LJO-S/antsdr-fmcw-radar/scripts/antenna_design/eps_r_sweep.md

# eps_r sweep, fixed geometry (K8 calibration curve)

Generated by `sweep_eps_r.py`, do not edit by hand. Per-run plots and logs in `sweep/`.

One geometry in every row: the eps_r 4.40 design from `results.md` (patch L
11.842 mm, W 15.728 mm, inset 3.700 mm, line 2.868 mm), on one shared mesh
(`--refine 1.5`, converged to ~3 MHz). Only the substrate's eps_r changes. FR4
dielectric h 1.500 mm, tan d 0.020. S11 is at the board edge, vs 50 Ohm. Efficiency
is radiated over accepted power at the port's probes (PEC copper, so no conductor loss);
gain = Dmax x efficiency.

| eps_r | S11 min at (GHz) | S11 min (dB) | -10 dB band (GHz) | worst over 5.75-5.85 GHz (dB) | Dmax (dBi) | Efficiency (%) | Gain (dBi) |
|---|---|---|---|---|---|---|---|
| 4.20 | 5.924 | -30.2 | 5.813-6.038 | -6.7 | 8.0 | 61 | 5.9 |
| 4.30 | 5.862 | -32.0 | 5.752-5.975 | -9.9 | 8.0 | 60 | 5.8 |
| 4.40 | 5.801 | -33.4 | 5.692-5.914 | -16.3 | 8.0 | 59 | 5.7 |
| 4.50 | 5.743 | -36.7 | 5.636-5.853 | -10.3 | 7.9 | 58 | 5.6 |
| 4.60 | 5.686 | -41.3 | 5.581-5.795 | -7.0 | 7.9 | 58 | 5.5 |

Slope (linear fit): -60 MHz per +0.1 eps_r.

Reading a measurement: `python sweep_eps_r.py --measured <GHz>` interpolates this table
(no new simulation), and prints the guide's formula
`eps_r ~ 4.4 * (f_sim / f_meas)^2` (f_sim = 5.801 GHz) as a cross-check.

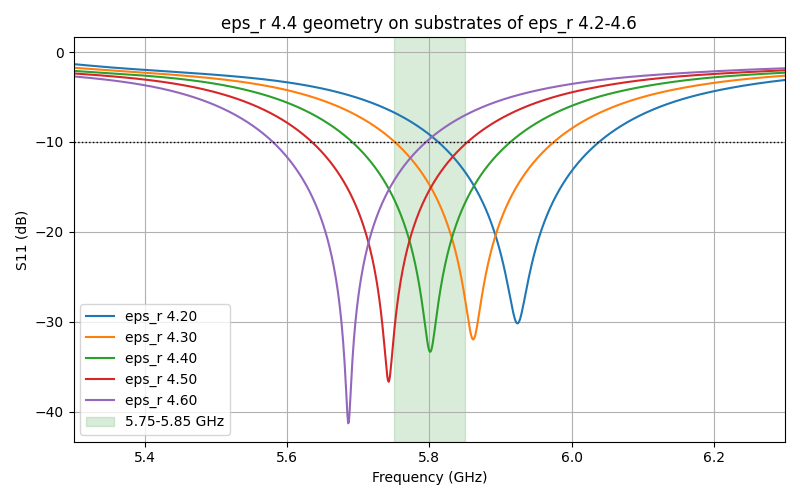
[picture p1: scripts/antenna_design/eps_r_sweep.png]
S11 vs eps_r
