LJO-S/antsdr-fmcw-radar/scripts/antenna_design/k8/k8_summary.md

# K8 summary

K8 denotes the abbreviation of Part K Step 8 in Phase 6 of radar project.
Generated by `k8_analyze.py` after measuring the patch and line-pair from JLCPCB (21 Oct 2026).

```
K8 measurement analysis

Patch board
  S11 minimum:        5.8193 GHz, -11.5 dB
  -10 dB band:        5.608-5.910 GHz
  worst S11 5.75-5.85 GHz: -11.0 dB
  eps_r (table):      4.370
  eps_r (SMA-corr.):  4.412   (f_min - 25 MHz, +-10 MHz ~ +-0.02; the better patch value)
  eps_r (formula):    4.373   (4.4 * (f_sim / f_meas)^2, cross-check)

Line pair (dL 70.0 mm, W 2.868 mm, h 1.50 mm)
  eps_eff at 5.8 GHz: 3.826   (eigenvalue method, launches cancelled; 2 pi wraps added: 2)
  eps_eff 5.75-5.85:  3.823 +- 0.024 (ripple)
  group index:        2.031
  lambda_g at 5.8 GHz: 26.43 mm   (K9 element pitch)
  loss:               0.0195 +- 0.0056 dB/mm (mean over band, ripple)
  cross-check, plain S21 difference: eps_eff 3.822, 0.0115 dB/mm (launches do not cancel in |S21|)
  worst S11 5.75-5.85 GHz: short -5.9 dB, long -8.2 dB
  Z0 (H-J, eps_r 4.4): 50.1 Ohm
  eps_r, Kirschning-Jansen inverted: 4.867   (cross-check)
  eps_r, simulated table (refine 1.5): raw 4.848, corrected 4.847 (35 um copper: eps_eff - 0.0011)
  WARNING: measured eps_eff is outside the simulated table: eps_r is an extrapolation
  (FR4 is anisotropic: the line and patch eps_r may differ by a few %)
  eps_eff predicted from the patch eps_r: 3.452 (measured 3.826)
  conductor loss assumed: 1.07-1.45 dB/m (0.63 smooth x 1.7-2.3 roughness/HASL, an estimate)
  tan d: 0.0184 - 0.0188   (high end = low conductor loss)
```
