LJO-S/antsdr-fmcw-radar/docs/datasheets/hf240.png

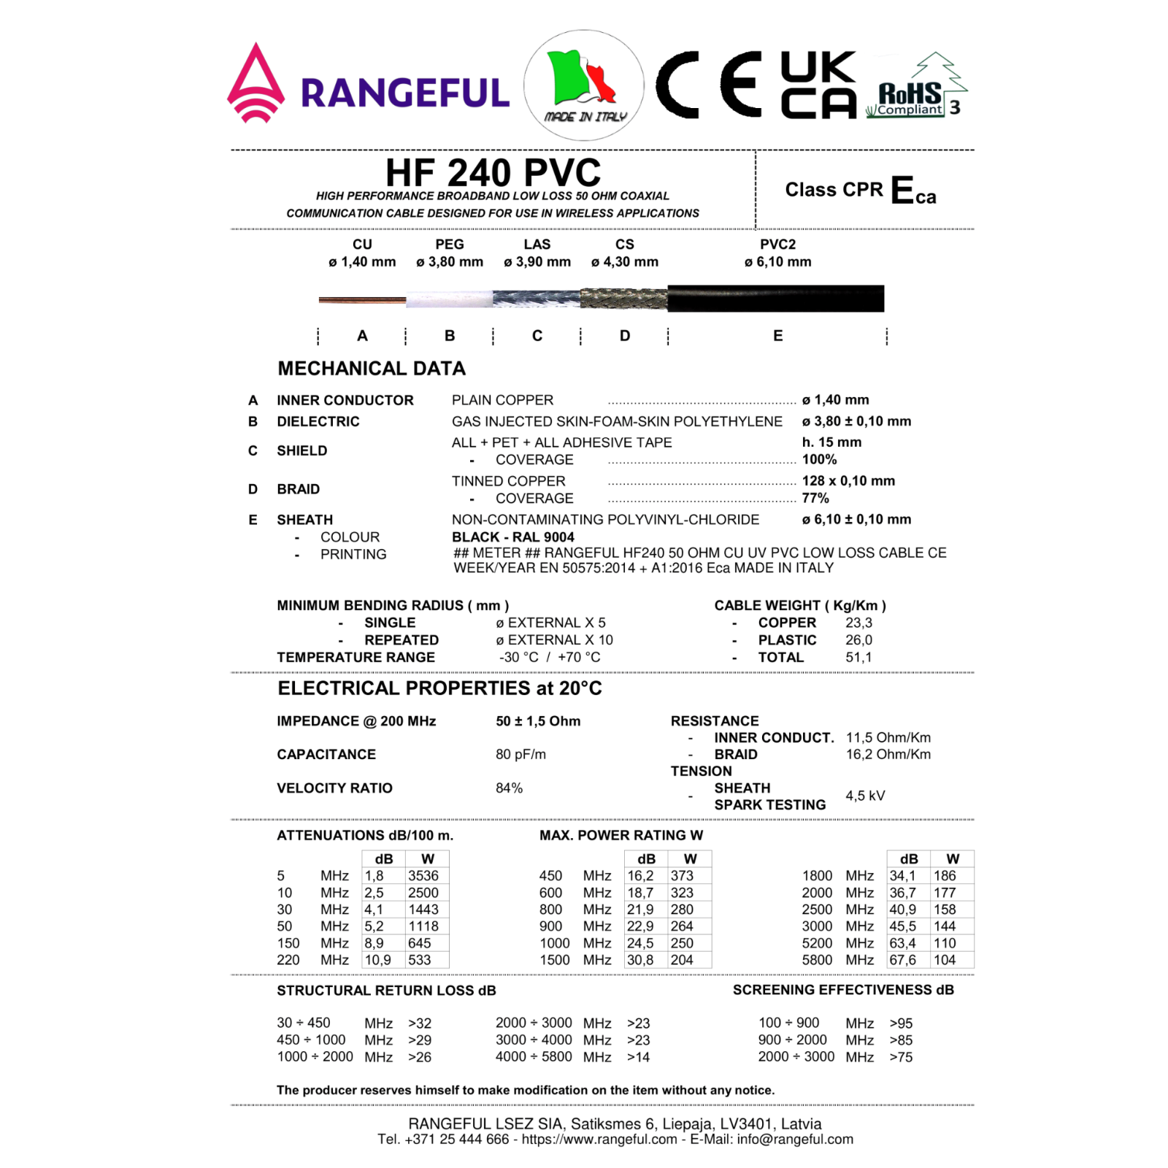
docs/datasheets/hf240.png
