LJO-S/antsdr-fmcw-radar/scripts/antenna_design/k8/k8_eps_eff.png

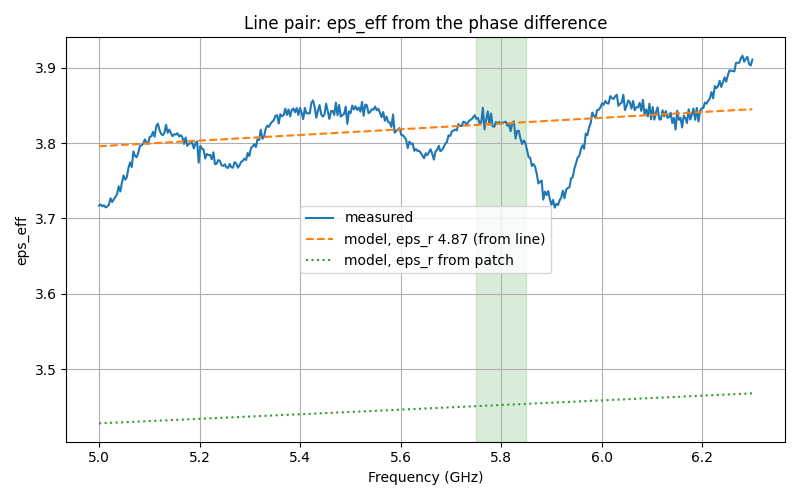
scripts/antenna_design/k8/k8_eps_eff.png
