LJO-S/antsdr-fmcw-radar/scripts/antenna_design/k8/k8_patch_s11.png

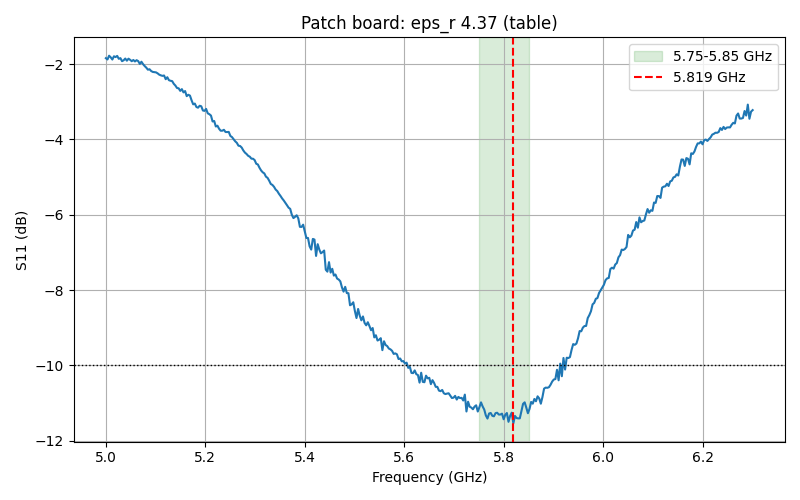
scripts/antenna_design/k8/k8_patch_s11.png
