LJO-S/antsdr-fmcw-radar/scripts/antenna_design/k8/k8_s21.png

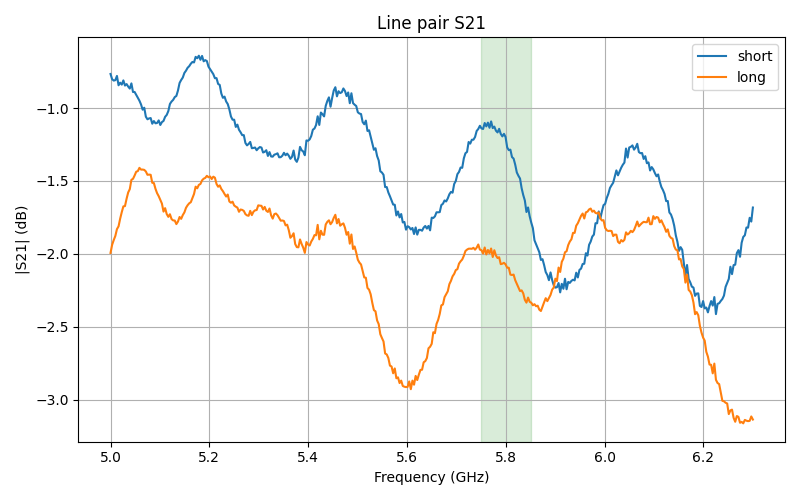
scripts/antenna_design/k8/k8_s21.png
