LJO-S/antsdr-fmcw-radar/src/python/image-1.png

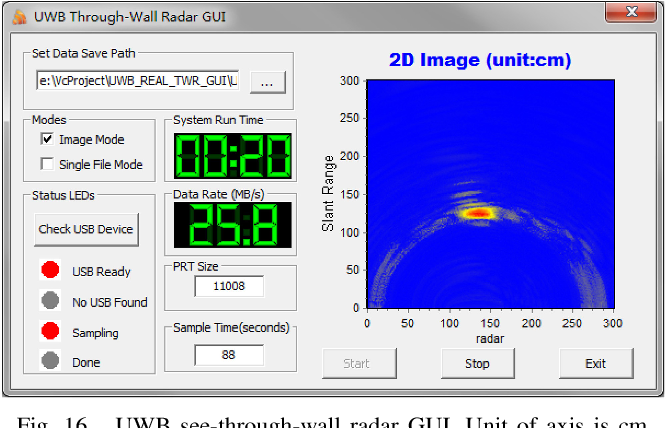
src/python/image-1.png
