LJO-S/antsdr-fmcw-radar/src/python/image.png

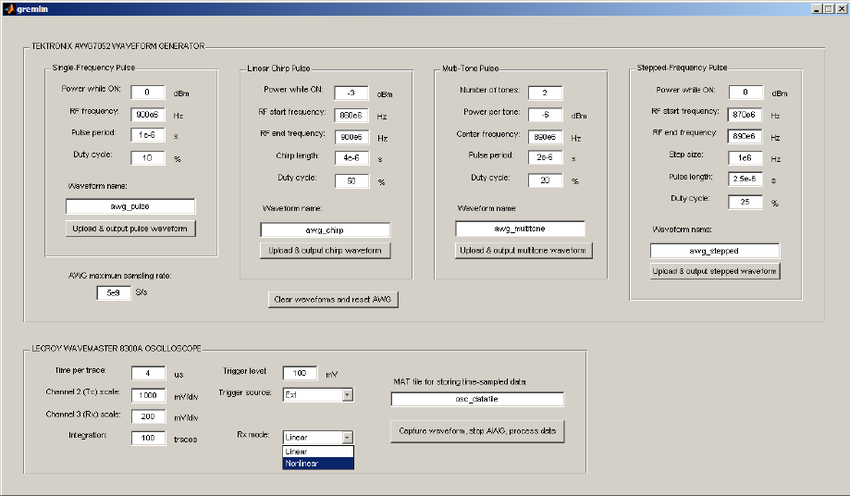
src/python/image.png
