LJO-S/antsdr-fmcw-radar/docs/AntSDR_Phase6_Tracking_Antennas_Angle_Guide.md

# AntSDR E200 - Phase 6: RF bench, patch antennas, 2T1R angle (Part K)

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

## 1. What and why

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

```
software lane:  K1 profile -> K2 recorder   (tracker: Phase 7)
                                  \-> K6 field day 1 (COTS antennas)
RF lane:        K4 VNA on owned gear -> K5 soldering + J30 header -> K7 TX switch
                                                     \-> K8 single patch -> K9 columns
then:           K10 angle on host -> K11 field day 2
gate:           Section 11, fabric FFT/CFAR
```

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

### 1.1 How angle works here: 2T1R time-division MIMO

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

What it costs:

- Each antenna gets every second chirp, so the slow-time interval is `T_rep = 2T`,
  as in triangle mode: unambiguous velocity 129 -> 64 m/s. With `CHIRP_REPS` chirps
  per antenna the CPI doubles to 25.6 ms and velocity bins shrink to 1.01 m/s.
- A moving target's phase also advances between an A chirp and the next B chirp.
  The host removes that term with the measured Doppler (Section 10.1).
- The fabric drives the switch from the NCO's chirp boundary, so TDM needs fabric
  mode. Software mode does not know where a chirp starts.

### 1.2 Why not two receivers (2R2T)

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

### 1.3 The link-budget consequence of patches

Under the 25 mW SRD EIRP cap, **TX antenna gain and TX-side loss are nearly free**:
a lower-gain TX antenna or the switch's insertion loss just takes more TX port power.
The limit: with ~+5 dBm at the port, 2.0 dB of switch (HMC849A module, predicted) and 1.9 dB
of cable (2 m HF240, measured in K4), the TX antenna needs ~13 dBi to reach the cap. Only one TX antenna radiates at a time, so
the cap applies per antenna. **RX gain is the cost**: range goes as `G_rx^(1/4)`.

| RX antenna | vs the 30 dBi grid | Range factor |
|---|---|---|
| COTS sector, 16 dBi | -14 dB | 0.45 |
| 1x8 column, RO4350B 1.52 mm, ~14.5 dBi (model) | -15.5 dB | 0.41 |
| 1x8 column, FR4, 11.0 dBi (sim) | -19 dB | 0.34 |

So roughly a third of the grid's range: a person at a couple of hundred metres, cars
further. `G_rx^(1/4)` only holds below the two-ray crossover (~350 m for a person at
1.5 m antenna height); beyond it, antenna height helps more than RX gain. The beams
get wide (~80 deg in azimuth, vs a few degrees for the grid), so more ground clutter
enters and MTI will matter more than it did in Part G.

---

## 2. K1 - profile the host (no board)

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

---

## 3. K2 - recorder and replay (no board)

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

**Format**, one directory per session:

- `session.json`: `dataclasses.asdict(cfg)`, MAGIC, `git describe` of this repo,
  wall-clock start, free-text notes.
- `blocks.bin`: raw capture blocks appended exactly as the DMA delivered them
  (int16, interleaved, before trim and before `TargetSim`).
- `index.csv`: one line per block, `monotonic_t, byte_offset, n_bytes`, flushed
  per line so a crash loses at most one block.
- `detections.jsonl`: the live detection list per CPI. It makes replay
  self-checking.

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

---

## 4. K3 - tracker in range and velocity: moved to Phase 7

Now Part L, steps L1-L4, in `docs/AntSDR_Phase7_Tracking_Guide.md` (2026-11-05).

---

## 5. K4 - RF bench kit and VNA basics (no soldering)

Read first: 13.1.

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

### 5.1 Kit

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

### 5.2 Measurements on owned gear

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

Done when every item has prediction, measurement and explanation in a table
(`hardware/bench_measurements.md`).

---

## 6. K5 - soldering and the J30 GPIO header

Read first: 13.1 (soldering).

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

Done when every J30 GPIO pin is mapped and toggles 0 / 3.3 V.

---

## 7. K6 - field day 1: fabric on real RF (board, weather)

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

1. **COTS, software mode**, recording on: a static scene, then movers. Put a corner
   reflector at a tape- or laser-measured range. A trihedral with 30 cm edges is
   ~12.7 m^2 (`4 pi a^4 / (3 lambda^2)`). It is also the end-to-end range-axis check
   Part F skipped.
2. **Delay**: `dechirp_verify.py --no-loopback --sweep` (`SDR_LOOPBACK_EN = False`),
   starting the sweep at 0. Expect 61 +-1: 1.5 m of air is ~5 ns, ~0.3 samples.
3. **A/B**: `dechirp_verify.py --no-loopback --decimate 8`, software vs fabric /8.
   Compare only the static content (leakage, reflector, clutter); movers differ
   between the two phases.
4. **Fabric /8 in the app**, recording on: cars, people on foot, bikes, at several
   ranges, plus a quiet stretch.

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

---

## 8. K7 - the TX switch

Read first: 13.1 (the datasheet exercise), 13.4.

### 8.1 The part

- **AliExpress "RF switch module SPDT 6 GHz", HMC849A variant** (bought). Chip
  datasheet at 5.8 GHz: ~1.7 dB IL (2.5 max), ~40 dB isolation (35 min), 150 ns
  switching (600 max), one control line (VIH 2.0 V), single 3-5 V supply, ESD class
  1A (fragile). SMA ports and a header are fitted, so it wires with Dupont leads. The
  same listing sells an HMC8038 variant (less IL, more isolation) and an **HMC349
  variant (4 GHz max: wrong part)**. Buy two: clones vary.
- Unverified on the module: the header pinout, whether EN is tied low (it must be
  low), the real IL at 5.8 GHz on its FR4, whether the chip is genuine. 8.2 answers
  all four.
- Known-good fallback: Mini-Circuits ZFSWA2-63DR+ (DC-6 GHz, one CMOS line, 2.0 dB
  IL at 6 GHz; +V on a feed-through pin).
- Avoid parts that need two complementary control lines or a negative supply
  (PE42420, ADRF5020 and similar).
- Supply: J30 pin 1 (3.3 V) if the module accepts 3.3 V. Check its supply current
  first.

### 8.2 Characterize it on the VNA

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

### 8.3 HDL (MAGIC -> FMC5 = `0x464D4335`)

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

### 8.4 Bench test in the radar (no antennas)

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

Done when the VNA numbers are written down, VUnit is green, and the bench test
passes.

---

## 9. K8, K9 - patch antennas

Read first: 13.2.

### 9.1 Targets

- **Match**: S11 < -10 dB over 5.75-5.85 GHz (the chirp spans 5.775-5.825).
- **Gain**: ~11 dBi per column on FR4 (sim 11.0; FR4 loss costs ~4 dB).
- **Beam**: azimuth HPBW >= 60 deg, elevation ~12 deg.
- **Polarization**: linear, the same on TX and RX. When mixing with the COTS
  antennas, match their polarization.

### 9.2 Why columns, not square arrays

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

### 9.3 K8 - single patch first

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

### 9.4 K9 - columns

Designed in `scripts/antenna_design/column_sim.py`; results in `results.md`.

- Series-fed 1x8, end-fed, vertical polarization. The pitch is set by the in-phase
  condition (patch + connector): 24.6 mm in the sim (0.48 lambda0, no grating
  lobes). The column is ~23 cm long.
- **Uniform, no taper.** The elevation sidelobes hit the ground within ~4 m, inside
  the close-in mask; the clutter that matters is main-beam ground from ~15 m out,
  which only MTI removes. A Taylor taper is a learning variant (sim: -19 / -22 dB,
  with per-section connector lengths).
- **TX board**: two columns, translated copies, centre spacing lambda/2 = 25.9 mm.
  Identical straight feeds to the SMAs. Sim coupling -24 dB. Do not widen the
  spacing: at 0.6 lambda, strong close targets alias at +-56 deg. A tab with
  mounting holes for the switch module, behind the ground plane or past the feed end.
- **RX board**: one column of the same design, so the two-antenna gain method holds.
  For the first angle field day, the COTS sector (V port, tilted up ~4 deg) is a
  better RX: 16 dBi and 120 deg.
- A witness coupon (single patch or short line pair) on every board: the K9 FR4
  batch may not be K8's.
- Expected (sim, eps_r 4.4): 11.0 dBi, azimuth HPBW ~78 deg, elevation 13 deg,
  1.7 deg beam tilt per 0.1 eps_r. Re-tune L and the connector length once K8 gives
  eps_r.
- **fc is the trim for batch drift.** Patch resonance and section phase both scale
  with `f * sqrt(eps_eff)`, so a board with eps_r 0.1 high is the right board ~60 MHz
  lower: moving `CHIRP_FC_HZ` fixes match and tilt together. Legal window for a
  50 MHz chirp: fc 5.750-5.850 GHz (SRD), about +-0.08 eps_r. Untuned, the column
  already holds at eps_r +-0.1 (S11 <= -15 dB, tilt <= 2 deg, gain -0.7 dB), so the
  witness coupon picks fc; redesign only if the shift exceeds the window.
- Order the TX and RX boards together: one batch, one fc. Run the 9.5 turntable
  curve at the fc you will use.

### 9.5 K9 - bench measurements

- **S-parameters** (VNA from K4):
  - S11 of every column.
  - S21 between the two TX columns (coupling, target <= -20 dB, sim -24 dB; at
    -15 dB the uncalibrated angle error reaches ~8 deg).
  - S21 between the TX and RX boards vs spacing (isolation - this replaces Part G's
    skipped isolation item). Reference: the leakage the E200 sees with the COTS
    antennas at 1.5 m, measured once with the same RX gain.
- **Gain, two-antenna method with the E200**: the RX column and one TX column (same
  design) face to face at R >= 2 m (far field `2 D^2 / lambda` ~ 1.9 m for a 23 cm
  column).
  - Reference: TX cable -> known pad -> RX cable. Read the peak level in the range
    profile (`dechirp_verify.range_profile_db`: no close-in mask).
  - Then swap the pad for the two antennas, same RX gain:

    ```
    G_dBi = 0.5 * (level_ant - level_ref - pad_dB + FSPL(R))
    FSPL(R) = 20*log10(4*pi*R / lambda)      # 53.7 dB at 2 m, 57.3 dB at 3 m
    ```

  - The pad keeps RX below its +2.5 dBm absolute maximum; keep the TX low.
- **Pattern**: rotate the TX board on a marked turntable (5 deg steps), RX column
  fixed >= 2 m away, TDM on. Record the A and B levels (HPBW, sidelobes) and the
  **A-B phase difference vs angle** - K10's calibration curve. It is mandatory: in
  the sim, the curve is 4.6 deg rms off `pi sin(theta)`, ~2 deg of angle at 30 deg.
- Measure outdoors, or with walls and floor far away, antennas >= 1.5 m high. A
  floor bounce ruins a pattern.

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

### 9.6 TX power with patches

```
SDR_TX_GAIN_DB ~ 14 - G_tx + L_txcable + L_switch - 6.5   # dB; 6.5 dBm = typ port at 0 dB
```

`L_switch` is the IL measured in 8.2. Example: G_tx 12 dBi, 1.9 dB of cable, 2.0 dB
of switch gives -0.6; use -2 for margin. Put the same value into
`SDR_TX_GAIN_MAX_DB` for field sessions, so a typo cannot exceed the limit.

---

## 10. K10 - angle on the host; K11 - field day 2

### 10.1 K10 - angle (TDM)

Read first: 13.4.

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

### 10.2 K11 - field day 2

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

- psi0 first, from a corner reflector carried radially along boresight (K9 in
  `TODO.md`).
- One change at a time: the RX column in place of the grid (COTS sector still TX),
  then the TX board through the switch with TDM on. Set the TX gain per 9.6.
- Then a person walking a known path and a car along a road. Record everything.

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

---

## 11. Decision gate - fabric FFT/CFAR

Not planned in Phase 6. Revisit when one of these holds:

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

Design notes for when it comes:

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

---

## 12. Troubleshooting

- **Patch resonance >100 MHz off** -> eps_r. Re-extract it from the single patch
  (9.3) instead of trimming blindly.
- **Pattern full of ripple** -> multipath, usually a floor or wall bounce. Go
  outdoors and higher.
- **Isolation reads the same whatever the switch** -> you are at the VNA's floor
  (K4). Quote it as ">= floor".
- **Even and odd rows at the same level in 8.4** -> the switch is not switching:
  EN not low, no VDD, the wrong J30 pin, or `tdm_en` not committed.
- **The loud row changes between captures** -> the DMA sync still fires per chirp,
  not per pair (8.3).
- **Angle drifts with target speed** -> the Doppler term is missing or has the
  wrong sign (10.1).
- **Angles mirrored** -> the conj convention or A and B swapped (10.1). Fix by
  experiment, then write it down.
- **RX saturates with the patches close together** -> isolation: more spacing, a
  metal fence between the boards, or lower RX gain. Check against the 9.5 S21
  numbers.

## 13. Reading - before each lane

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

### 13.1 RF measurement and soldering (before K4)

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

### 13.2 Antennas (before K8)

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

Exercises:
- Compute W, L and the 50 ohm line width by hand from the Balanis and Pozar
  formulas, and compare with 9.3.
- Simulate your 5.8 GHz patch and sweep eps_r over 4.2-4.6. Watching the
  resonance move is the argument for K8's calibration spin.
- Plot array factors in numpy: 8 elements at 0.55 lambda (the column in
  elevation), two elements at lambda/2 and at 2.8 lambda (9.2's ambiguity table).

### 13.3 Tracking: moved to Phase 7

Section 4 of `docs/AntSDR_Phase7_Tracking_Guide.md` (2026-11-05).

### 13.4 Angle estimation and TDM-MIMO (before K7 and K10)

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

## Appendix A - Phase 6 kit

Owned: pads, terminations, HF240 cables, VBFZ filters, jumpers, COTS antennas,
tripods (`hardware/materials.md`).

To buy, in the order the steps need it:

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

## Appendix B - 2R2T fallback (K0 results, 2026-09-28)

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
