LJO-S/antsdr-fmcw-radar/scripts/antenna_design/tx/tx.kicad_pcb

## KiCad design scripts/antenna_design/tx/tx.kicad_pcb (2026-10-25)

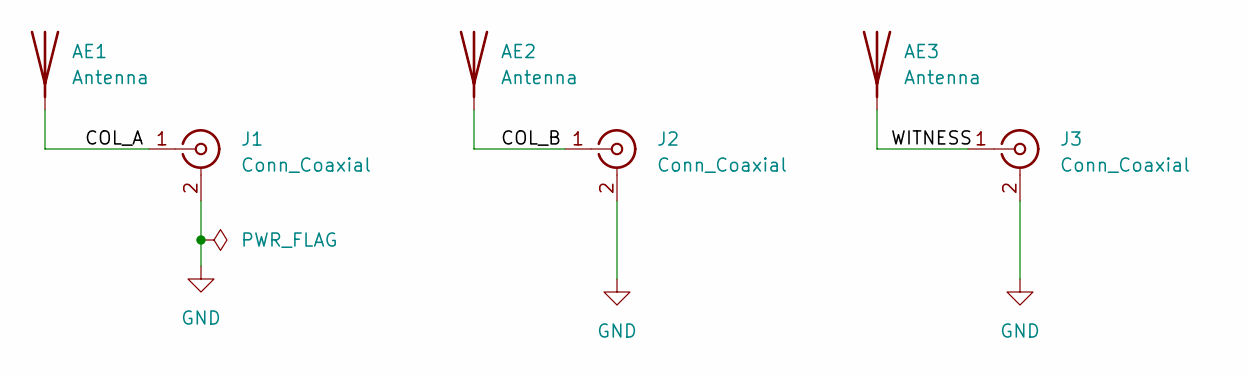
[picture p8: schematic tx.kicad_sch, Tx Column 2x8 Array]

Parts:
AE1, AE2: Antenna; K9_column_N8_uniform
AE3: Antenna; K8_patch_witness
J1, J2, J3: Conn_Coaxial; SMA_Molex_73251-1153_EdgeMount_Horizontal

Connections:
/COL_A: AE1.1 (A_1), J1.1 (In)
/COL_B: AE2.1 (A_1), J2.1 (In)
/WITNESS: AE3.1 (A_1), J3.1 (In)
GND: J1.2 (Ext), J2.2 (Ext), J3.2 (Ext)

Board: 2 copper layers, 12 parts (0 on the bottom side), 4 nets, no tracks yet.

Other parts of the board:
H0, H1, H2, H3, H4, H5: MountingHole_2.2mm_M2
