LJO-S/antsdr-fmcw-radar/scripts/antenna_design/line-pair/line-pair.kicad_pcb

## KiCad design scripts/antenna_design/line-pair/line-pair.kicad_pcb (2026-10-05)

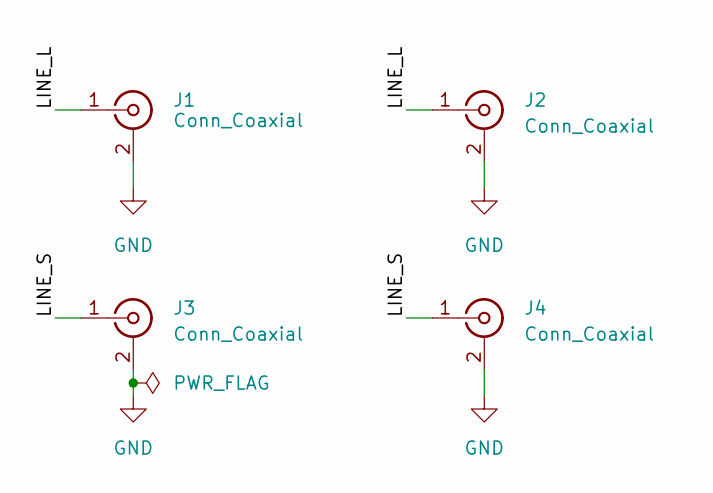
[picture p9: schematic line-pair.kicad_sch]

Parts:
J1, J2, J3, J4: Conn_Coaxial; SMA_Molex_73251-1153_EdgeMount_Horizontal

Connections:
/LINE_L: J1.1 (In), J2.1 (In)
/LINE_S: J3.1 (In), J4.1 (In)
GND: J1.2 (Ext), J2.2 (Ext), J3.2 (Ext), J4.2 (Ext)

Board: 2 copper layers, 4 parts (0 on the bottom side), 3 nets, no tracks yet.
