LJO-S/antsdr-fmcw-radar/(commit log)

2026-06-29 Update radar configuration and GUI for improved detection visualization
    - Adjust CHIRP_REPS and OP_RANGE_FACTOR in RadarConfig for better performance
    - Add operational range and velocity calculations to RadarConfig
    - Enhance GUI layout by adding a toggle for up/down detections
    - Implement detection limits in the soft model for better target generation
    - Clean up commented-out target generation code and add random target generation logic
2026-06-30 Implement frame synchronization and chirp offset estimation in soft model tests
2026-07-05 dsp.py: - Add loopback delay, velocity, noise additions - Fix frame sync to be linear instead of circular
    config:
    - Add loopback parameters
    - jsut captures data
    app.py:
    - initial issue
    - Add worker threads and GUI
    capture.py:
    - initial issue
    processing.py:
    - initial issue
    - does the CPI work
    sdr.py:
    - move register writing into start() to handle re-configuration down the road
2026-07-09 Change sample delay into meters in loopback
2026-07-11 WIP for GUI overhaul: - config.py: add defaults and metadata fields - dsp.py + sdr.py: add inst_freq - gui.py: WIP for button, param list, new signal GUI
2026-07-11 Connect worker/gui config emit threads and fix some related bugs.
2026-07-12 dsp.py: add spectrogram helper
    gui.py: remove helper
    app.py: route if signal and connect rx+if spec emit to gui
    processing.py: wire if signal out
2026-07-17 Add block diagram for 5.8 GHz FMCW Radar and materials list for hardware components
    - Created a detailed SVG block diagram illustrating the TX and RX chains, including components like the AD9361, LPF/BPF, PA, and antennas.
    - Added a comprehensive materials list for hardware procurement, outlining phases for ordering components, pricing, and sourcing strategies.
2026-07-20 Summary
    - Add MTI parameters and set new defaults
    dsp:
    - Add MTI processing
    gui:
    - add MTI enable button
    app:
    - connect MTI enable signals
    capture:
    - decouple loopback gating on fake targets
    target_sim:
    - add loopback gating on noise
    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
2026-07-28 sdr.py: - set clamps to tx gain - tidy up close()
    config.py:
    - insert tx gain clamp values
2026-07-28 Update TODO.md and add fmcw_fabric_architecture.svg
    - Mark several tasks as completed in TODO.md related to Phase F kit ordering, C6 test, RX-live check, cable bring-up, MGC sweep, and AD9361 tracking knobs inspection.
    - Remove the optional task for a long cable as a fixed real "target".
    - Add detailed descriptions for the Phase 4 architecture and upcoming tasks in the firmware development process.
    - Introduce a new SVG file, fmcw_fabric_architecture.svg, illustrating the architecture of the fmcw_core module for Phase 4, including control plane, TX and RX lanes, and notes on the design.
2026-07-30 Add vhdl_ls.toml to track hdl files
2026-08-30 Update hardware materials: refine antenna sourcing details and adjust BPF plans
2026-09-23 Add RF Power and Spectrum documentation and update guide
2026-09-26 - Update TODO, Claude - Archive current guide - Comments
2026-09-26 Update TODO.md and add Phase 6 tracking guide
    - Updated the current state in TODO.md to reflect completion of Parts A-G and I, and outlined the next steps for Part K (tracking, patch antennas, 2R1T angle).
    - Added detailed documentation for Phase 6 in AntSDR_Phase6_Tracking_Antennas_2R_Guide.md, covering objectives, tasks, and specifications for tracking and antenna development.
    - Included specific tasks for K0 to K9, emphasizing the integration of tracking and angle estimation with new patch antennas.
2026-10-03 Add recorder: - dsp.py: add raw interleaved for block write - gui.py: add live record option and support for playback - playback.py: replaces RadarWorker thread for offline playback - replay.py: hand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
    comm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
2026-10-03 Add Simple Patch Antenna script for 5.8 GHz antenna design and simulation
2026-10-03 - add antenna sim measurement prints and results.md -
2026-10-05 Add new sweep data files for antenna design simulations
2026-10-05 - Update gitingore, todo, guide and cluade - Fix scripts to handle sweep and mesh refinement - Update documentation for the antenna construction - Add kicad files
    [antenna-bringup.kicad_pcb, antenna-bringup.kicad_sch, line-pair.kicad_pcb, line-pair.kicad_sch]
2026-10-05 Update .gitignore to exclude fp-info-cache and gerbers directories
2026-10-08 Add validation for SDR_RX_MARGIN_PERIODS and adjust TX buffer size for DMA alignment
2026-10-13 - Update CLAUDE, TODO, materials and gitignore - Move growth to optional.md - antenna_design/: add a bunch of simulation scripts for line pairs, SMA launch, column simulation and footprint auto-gener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
2026-10-15 - Add support for TDM capture and DSP - Rename config to easily fetch legs per period - Forbid triangle + TDM simultaneously
2026-10-15 Update documentation for antenna switch module and pin mapping
2026-10-20 - gui.py: fix velocity min/max limits - Update claude & TODO and GUide
2026-10-24 Update antenna scripts and docs:
    - Update TODO and various .md files
    - Modify openEMS and footprint gen scripts to account for various measurement findings
    - Add k8 analyze results
2026-10-24 Rename stuff and add the antenna element
2026-10-25 Add Tx kicad files
2026-10-26 Prune docs and comments and add rx kicad design
2026-10-31 Fix subbin refinement prev acting on linear power and the CFAR costly convolution: - subbin refinement now using log power giving more accurate results - CFAR using boxsum, reducing time to calculate
2026-10-31 Move the velocity axis to T_EFF and speed up fake-target synthesis.
    - dsp.py: velocity axis on T_EFF, blocked Doppler phasor, apply_noise takes a float32 Generator
    - config.py: MAX_VELOCITY and velocity resolution on T_EFF
    - target_sim.py: apply_if builds each target as one outer product, own noise Generator (a_seed)
    - profile_cpi.py: mirror the Doppler wrap (dilate_doppler, wrap_velocity), seed the TargetSim
    - test_dsp.py: new suite (Doppler wrap, log sub-bin, velocity scale, apply_if, noise)
    - test_target_sim.py, test_soft_model.py: T_EFF tolerances, seeded TargetSim
    - CLAUDE.md, TODO: Host DSP pass steps 2-6 and K10 step 3 done
2026-11-01 Split CLAUDE.md into path-scoped rules
    - CLAUDE.md: keep project-wide rules (sign conventions, config, firmware stack, RF safety)
    - .claude/rules/{dsp,app,sdr,hdl}.md: area rules, loaded when matching files are opened
    - docs/rf_and_regulatory.md: AD9361 numbers, regulatory text, link budget, field test
    - hdl.md: merge the I5 decimation notes, remove duplicates, fix tdm_en in the
    pre-COMMIT word and the stale lpc-rate note
2026-11-07 Add first tracking exercise: - pypkgs.txt: add filterpy - *.py: tracker exercises
2026-11-13 Transfer PC/laptop: - add tracker to app.py - capture also emits time - fix replay and playback with tracks and --track to tune later - fix a bug in tracking with kinematic check - docs
2026-11-14 Fix History tab stall, 17 -> 50 CPIs/s with tab open - gui.py: draw history only when tab current, detections as mask image not scatter
2026-11-14 Fix tracker spur leak, sa 10. WIP (i) red - tracking.py: no births in NMS window of tentative track that met M of N - config.py: TRACK_STD_A 5 -> 10 - test_tracking.py: (g) share over 20 seeds, (i) 6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
2026-11-14 Add K9 bench files - k9_switch.ino: HMC849A switch picks column for VNA - k9_turntable.md: S-params + turntable procedure - mount/: K9 brackets/clamps scad, stl export, protractor strips
2026-11-14 Update TODO - L1 done, K9 measured, eps_r ~4.8 - 2026-11-13 review items: spur leak, coast confirm, fail floor - L3: capture stamp + History stall fixed
